Mohammed-Yaser99/Mini-5-phase-Production-Line-/README.md

be7a3260-bcdb-41d9-971e-5cd351a8e9dc

This Repository contains the working files for 5-phase Mini Production Line [ Feeding,Assembly,Disassembly,Storing,Sorting ] :
- Flowcharts for the code
- Code files for the project
- Video for the whole project in action
- Report with all project details and study cases
