Mohammed-Yaser99/Mini-5-phase-Production-Line-/MCT 381 Design of Mechatronics Systems 1.pdf

# MCT 381 Design of Mechatronics Systems 1

# Final term project

# Disassembly Module

# Submitted By:

# Name : Mohamed Yaser Mohamed

# ID: 17P8213

# Submitted to:

# Dr.Shady Maged

# Dr. Omar Shehata

## Contents

# Abstract

This report is a sub report which discusses the step by step procedure of creating the sorting and storage mechanisms used in a fully automated production line which consists of 5 modules.The assembly,disassembly,handling,sorting and storage and finally,feeding module.The production line starts with two parts fed on a conveyor and then assembled to be one product then stored in a shelf for a specific time then fed on another conveyor to be disassembled back then stored again in a magazine.Every detail of the disassembly module will be explained thoroughly starting from the basic idea to the mechanical CAD design moving to the electronic design as well as the software design.In addition,motor sizing and a description to the different mechanical fixations and considerations made for this module to do its function accurately and efficiently.

### 1.0 Introduction

The sorting and storage stations is considered as the bridge that connects the two halves of the conveyors with each other.as it takes the assembled product from one half of the project (Conveyor 1) and then store it within the shelves for a certain time ,then it descends to ground level (Conveyor 2 ) and then hands the product to it. In this report ,we will be discussing in detail the step by step manufacturing and implementation of the station including materials used, components used and the integration all the mechanical ,electrical and software blocks together.

### 2.0 System Requirements

The requirements of the sorting and storage station during the design phase were to:

build a system that is mechanically easy and fast to assemble

In addition, to be electrically/electronically organized so as to be able to diagnose any errors quickly.

Finally, to have a closed loop system that is fully automated.

### 3.0 Project Plan

Weeks 1-2 Brainstorming ideas for the system and learning the basics to build an accurate model and CAD design

Weeks 3-6 CAD Design as well as modeling and simulation of the system

Weeks 8-9 Listing and purchasing the necessary components for the system

Weeks 10-11 Mechanical assembly and setting up the electrical and pneumatic circuits

Weeks 12-13 Integrating the electrical,mechanical and pneumatic systems together by building a software program run by an ARDUINO UNO

Weeks 14-15 Testing the subsystem individually and integrating it with the other subsystems (Handling)

### 4.0 Mechanical Design

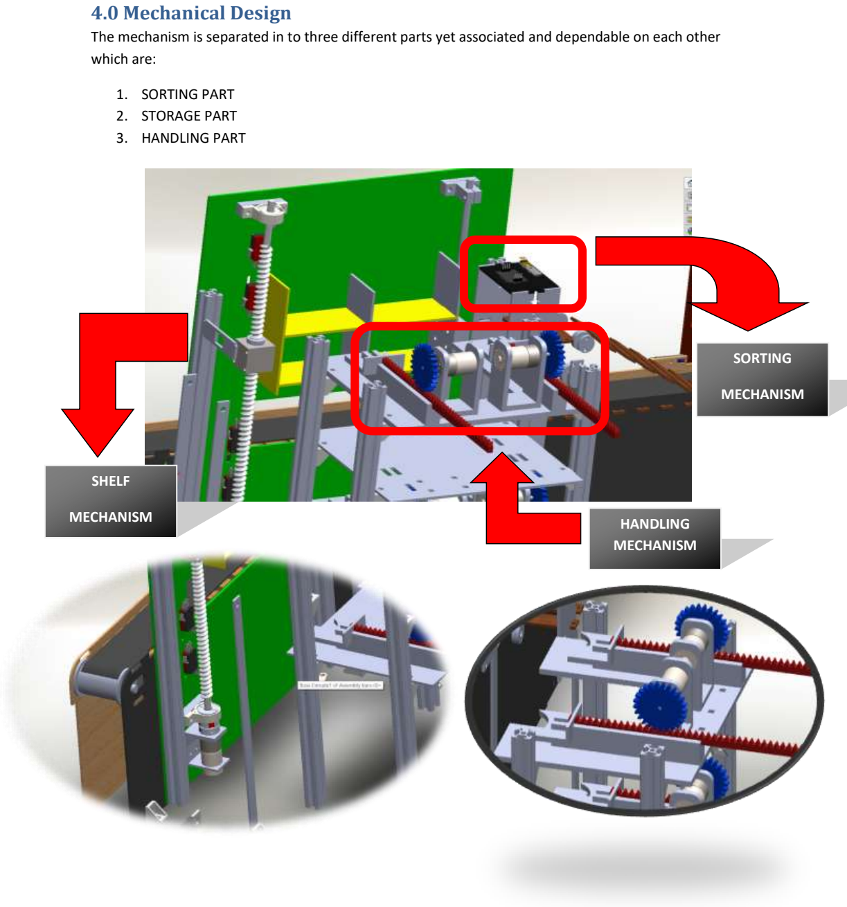
[picture p1: page 5]

The mechanism is separated in to three different parts yet associated and dependable on each other which are:

1. SORTING PART
2. STORAGE PART
3. HANDLING PART

HANDLING
MECHANISM

SORTING

MECHANISM

SHELF

MECHANISM

### 4.1 SORTING PART

This part is mainly electrical from my point of view as it’s mechanical part is mostly executed by the conveyor .

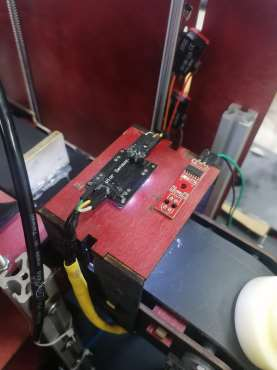
[picture p2: figure]

I decided to go for a color sensor to differentiate between the parts (GREEN & RED) so I mounted it on variables:

1. saves the color detected in a variable called color
2. checks if floor no.1 in the shelf is full or not

then the parts goes for the assembly module to get assembled, then when it’s done the conveyor runs upward or backward according to the color saved before until it reaches the Rack and Pinion (HANDLING MECHANISM) ,it stops in front of it using the distance sensor in conveyor 1 ,then conveyor 1 sends a signal to the shelf controller with the variable saved before and accordingly it decides which rack and pinion should work and whether the first floor is full or not so that the shelf ascends to put the part in the second floor.

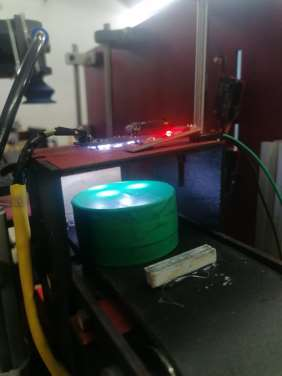
[picture p3: figure]

### 4.1.2 Components Used:

### Mechanical System Components

This part is Mainly executed mechanically with the help of the conveyor.

### Electrical System Components

1 color sensor

1 distance sensor

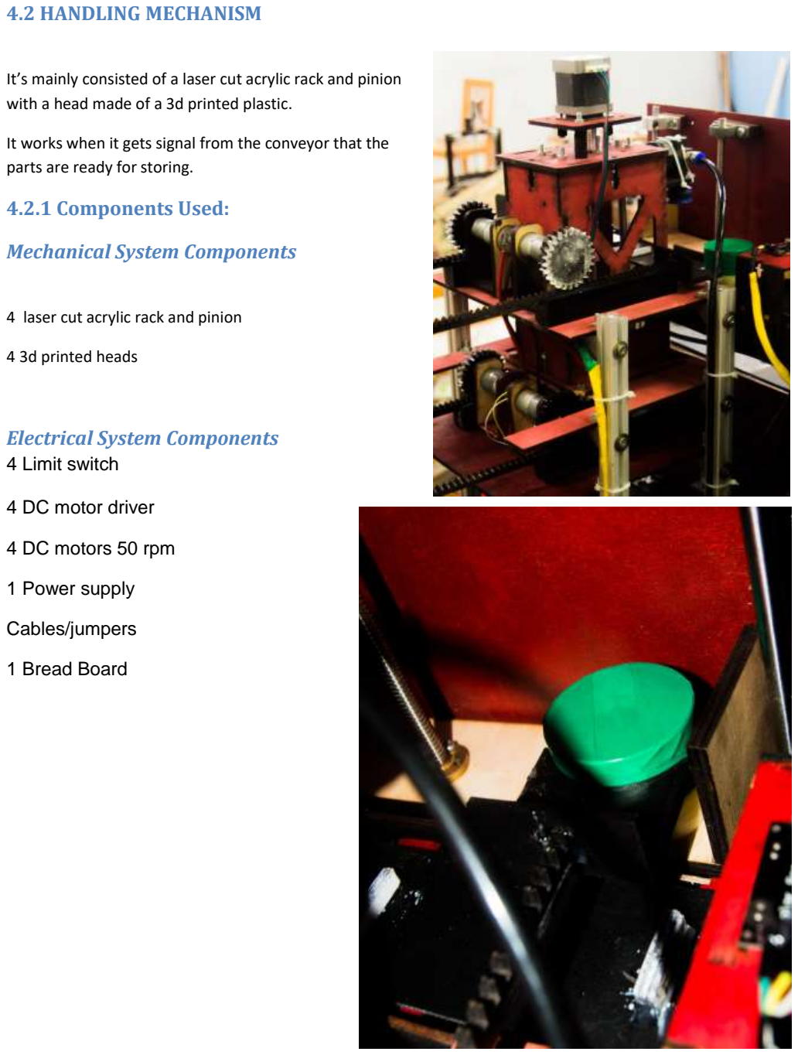
[picture p4: page 7]

### 4.2 HANDLING MECHANISM

It’s mainly consisted of a laser cut acrylic rack and pinion with a head made of a 3d printed plastic.

It works when it gets signal from the conveyor that the parts are ready for storing.

### 4.2.1 Components Used:

### Mechanical System Components

4 laser cut acrylic rack and pinion

4 3d printed heads

### Electrical System Components

4 Limit switch

4 DC motor driver

4 DC motors 50 rpm

1 Power supply

Cables/jumpers

1 Bread Board

### 4.3 SHELF MECHANISM

It consists of two parts the fixed part and the movable part.

The fixed part is big rectangle which hold all the components of the shelf and has a hole which lead to the second conveyor.it holds the motor the power screw and the supporting rod all fixed using vertical supports.

The movable part was laser cut and assembled as two floor shelf with a guiding nut on one side and linear bearing on the other.

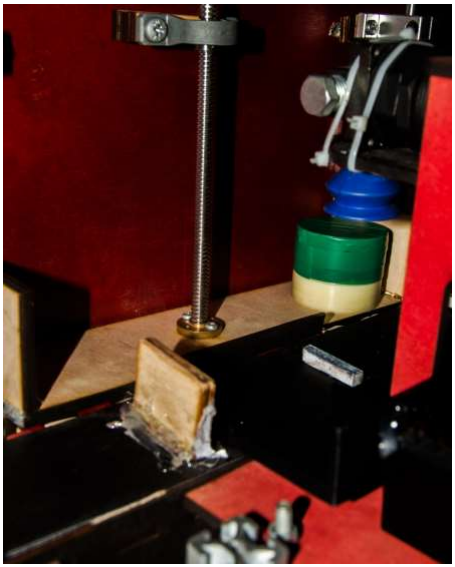
[picture p5: figure]

### 4.3.1 Components Used:

### Mechanical System Components

1 Lead Screw

1 Linear Bearings

4 Vertical Support

28 Bolts & Nuts

Washers

2 Supporting rod

4 20x20 square cross section supports

1 5 mm - 8 mm coupler

### Electrical System Components

4 Limit switch

1 DC motor driver

1 DC motor 250 rpm

1 Power supply

Cables/jumpers

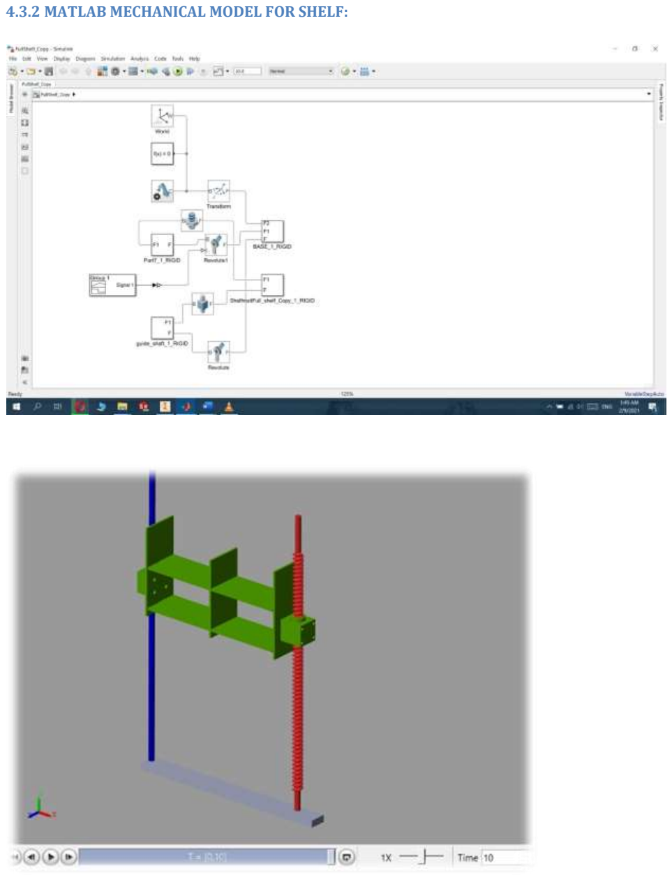
[picture p6: page 9]

### 4.3.2 MATLAB MECHANICAL MODEL FOR SHELF:

### 5.0 Electrical Design

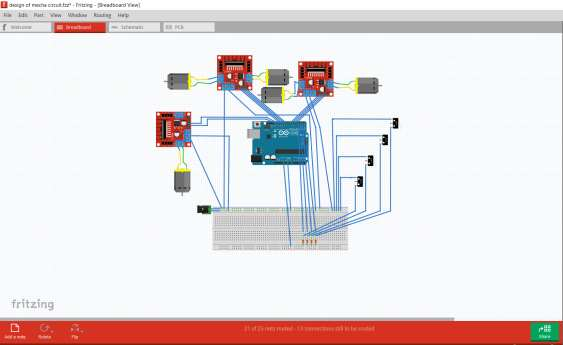
[picture p7: figure]

### 6.0 Software flowchart

FIRST STAGE:

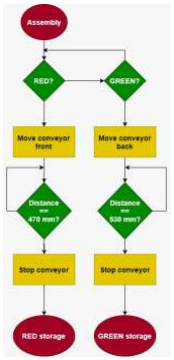
[picture p8: figure]
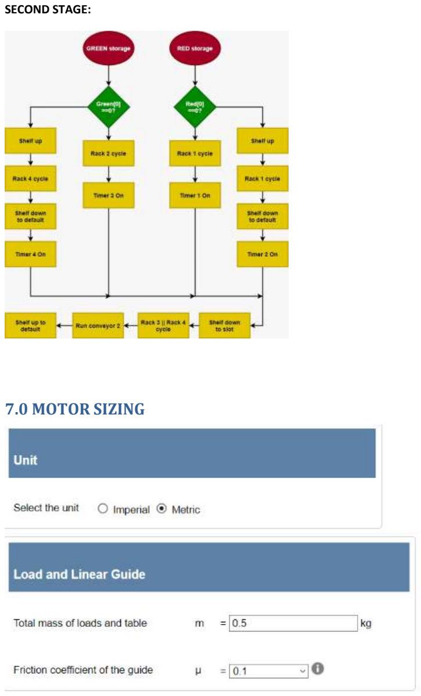
[picture p9: page 11]

SECOND STAGE:

### 7.0 MOTOR SIZING

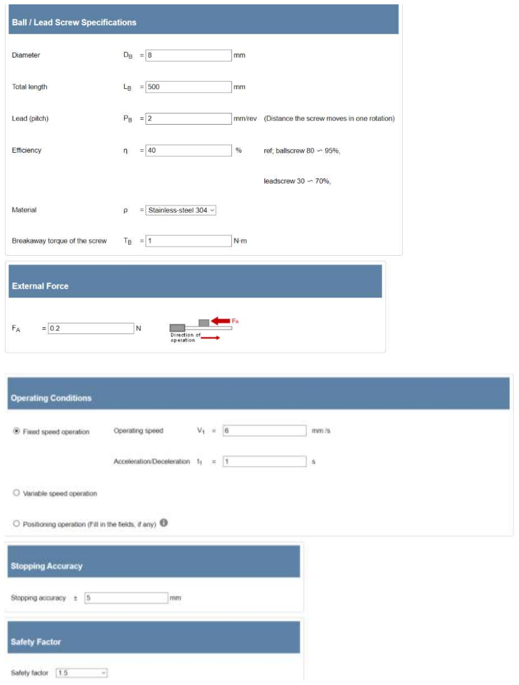
[picture p10: page 12]
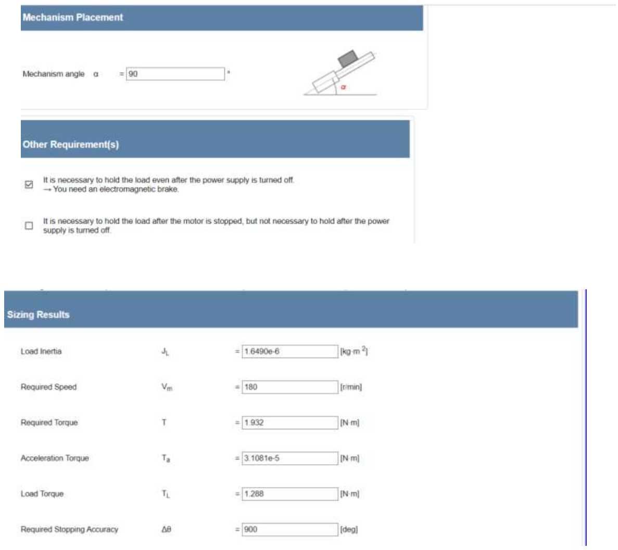
[picture p11: page 13]

### 8.0 Manufacturing Process

The manufacturing process in the sorting module included the usage of the laser printing technique to print everything from the walls that make up the shelf floor and the shelf back to the rack and pinions .MDF wood 6 mm and acrylic 6mm were used to assemble the station.

We also used 3d printing in making the piston heads and the dc motor holder.

After all the components were printed, the assembly process began.

### 8.1 Assembly of the module description

### SHELF ASSEMBLY

First the wall of the shelf was fixed using the steel sections,bolts and nuts in the base of the project. With that step done it made a good base for me to fix the rest of the components including the flanged bearings for the guidways and the power screw .

The walls of the shelf was assembled alone then fixed with power screw in the wall.a coupling was placed at the end of the power screw in which at the second end of it the dc motor-the main actuator- will be fixed.

Finally the limit switches was fixed using two bolts and nuts.

### RACK AND PINIONS ASSEMBLY

First 4 steel sections are fixed to the base then the tables were oriented on the required levels for the rack and pinions to operate. The rack and pinions guideways was fixed using super glue. The motors were placed in their pre-made holes in the tables.

### 9.0 SOFTWARE FLOW

First the color sensor senses the color of the part and saves it in a variable called color.This is done by calibration of the sensor and mapping the results. all is done in this function.

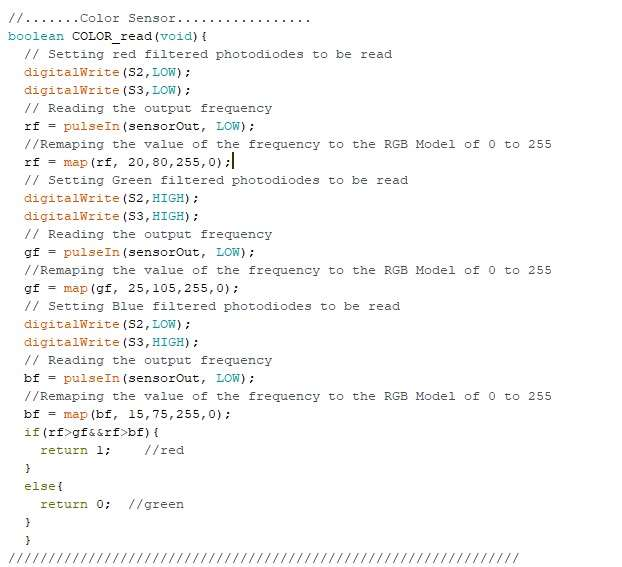
[picture p12: figure]

Second stage happens after the assembly finishes it’s work. The conveyor checks the color saved from the previous station and moves forward or backward according to the color of the product. It keeps moving until the distance sensor stops it by pre-determined distance to stop exactly in front of the rack & pinion.

Third stage the microcontroller checks if the first floor of the shelf is full .

if No it moves the rack and pinion to insert the product in the first floor and opens the timer related to this product and raises a flag means that the first floor is full.

If yes the shelf moves upward until it reaches the limit switch which says that the second floor in front of conveyor 1 .the rack and pinion moves to insert the product in the second floor then the shelf returns to it’s default position and enables the timer interrupt .

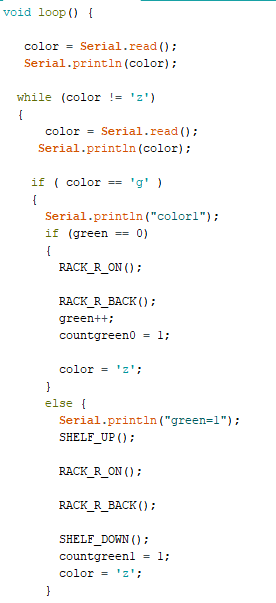
[picture p13: figure]
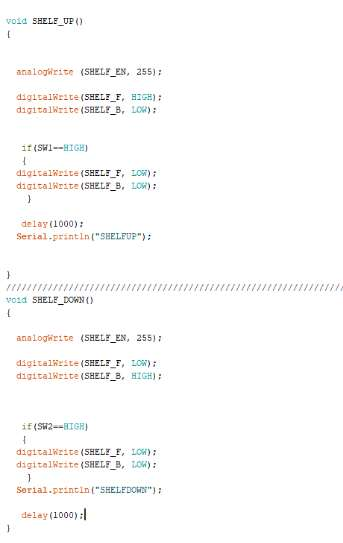
[picture p14: figure]

Forth stage the timer interrupt counts to 30sec then it automatically descends down to conveyor 2 and the lower rack and pinion operates according to which product is meant to exit.

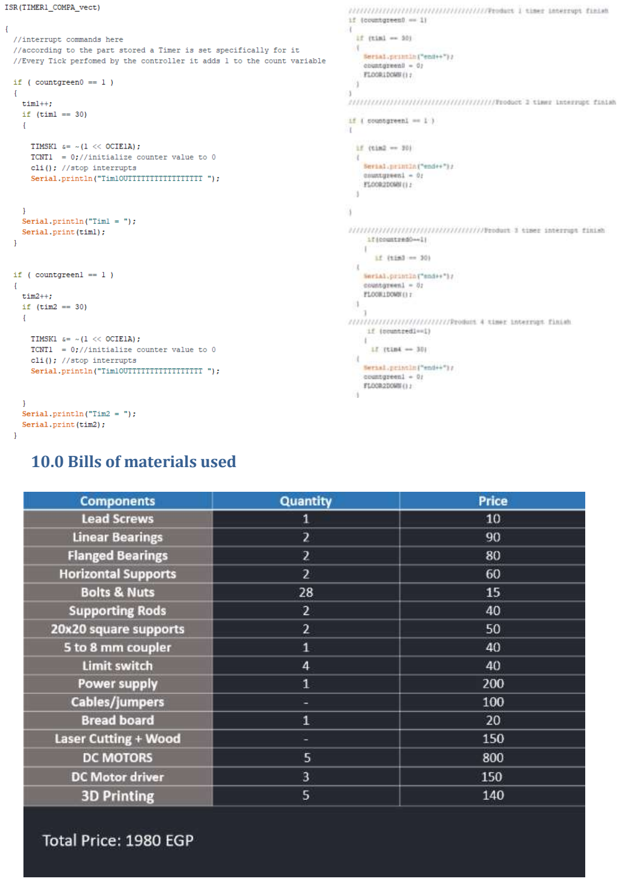
[picture p15: page 17]

### 10.0 Bills of materials used
